cmot17/nrfmicro/hardware/production/bom.csv

Designator | Footprint | Quantity | Value | LCSC Part #
D1 | D_SOD-323F | 1 | 1N5819
D2 | 0603 | 1 | WHITE | C2290
D3 | 0603 | 1 | RED | C2286
J1 | GT-USB-7047B | 1 | USB-C USB 2.0 MC-372 | C963217
JP1 | Jumper_SMD | 1 | SolderJumper_2_Open
Q1, Q2 | SOT-23 | 2 | AO3407
R1 | 0402 | 1 | 100K
R2, R3 | 0402 | 2 | 5.1K
R4, R8 | 0402 | 2 | 1K
R5 | 0402 | 1 | 10K
R6 | 0402 | 1 | 820K
R7, R9 | 0402 | 2 | 2M
U1 | E73-2G4M08S1C-52840 | 1 | E73-2G4M08S1C
U2 | SOT-23-5 | 1 | XC6220B331MR | C86534
U3 | SOT-23-5 | 1 | TP4054
X1 | Q13FC1350000400 | 1 | 32768kHz | C32346
